TylerBeaton/Ocean-Motion/Tools/Fusion360/PlatformSolverInvestigation/HANDOFF.md

# Fusion platform solver investigation — resume here

## User contract
Investigate script-driven platform poses with Fusion solving all six linkages as it does on mouse drag. Keep ALL existing work untouched. Only create/edit files in this new `Tools/Fusion360/PlatformSolverInvestigation/` directory. Preserve local work and do not commit, push, change branches, or save the user's CAD document without authorization. Offline CAD only; no physical actuator output.

## Workspace
Live repo: `/Users/tylerbeaton/Documents/Unity Projects/Ocean Motion`
Branch: `feature/unity-fusion-telemetry` (upstream fetched and equal at start).
The Hermes `.../orca/workspaces/Ocean Motion/main` tree is a DIFFERENT checkout. Work in the live repo above.
`baseline_hashes.json` records SHA-256 hashes of existing Fusion Python, Markdown, manifests and CSVs; compare before finishing to prove none were modified. Credentials/hidden environment files were not read and must remain untouched.

## Evidence inherited from user tests
- Mouse dragging the top platform articulates the mechanism.
- Direct top.transform2 writes moved the plate but not connected parts. An earlier computeAll() probe moved zero other occurrences.
- Driving root-context revolute joints moves the connected mechanism, but sequential coupled writes plus a fixed heave/two-tilt-only response approximation drift laterally/yaw and visibly pop.
- transformOccurrences([top], [matrix], False) matched a tiny +1 mm world Z / +0.15 deg local X/Y target, yet all six rotationValue changes were zero. User saw a slight plate lift and visible return after OK. This does NOT establish linkage articulation or stationary-base behavior.
- Existing UnityJointVisualPlayback now contains a slowed pose-test and servo body-relative diagnostics. No result from that revised diagnostic has been supplied. Do not modify it.

## Current status / exact next step
LIVE BUILD CHECKPOINT: current tool runtime lists two running children under `deleg_d2a90ce8`: sa-0-0bbceffb builds PlatformReconnectPlayback/ (actual CSV, six positively identified nub attachments only, nonzero proof before preview/full); sa-1-7f0c3046 builds PoseFeedbackPlayback/ (actual CSV, six ordinary revolute drives with numerical full6DOF feedback correcting XY/yaw). Both own separate new folders, must leave CHECKPOINT.md, tests, manifest and explicit disposable-copy consent; no old files or unknown joints changed. These candidates are NOT yet verified. Parent must inspect/run tests and real CSV planning, check frozen40hashes and update MORNING_CHECKLIST before saying ready.

Recovery caveat: the pre-existing paragraph below names `deleg_1e2e4dd1` and two differently named trial folders. It was discovered on a failed-context patch; current delegate list does NOT show that batch and file search found no *Trial* artifacts at this checkpoint. Preserve its notes, but do not assume those children/artifacts exist or succeeded. Reconcile actual files and active tasks on resume rather than overwriting retained work. Current live scopes do not overlap those names.

LATEST USER CORRECTION: diagnostics alone are insufficient. User explicitly requests scripts that actually animate from UNITY RECORDING, accepts multiple experimental attempts on disposable copies in morning. Do not present JointLocator/ManualDragCompare as that deliverable. Two CSV-driven candidates now building in separate folders via delegation `deleg_1e2e4dd1`: sa-0-c088456e UnityCommandPoseTrial (joint-aware transform inside Command.execute; unproved hypothesis), sa-1-688ebfb8 UnityNubReconnectTrial (only six known Nub 1–6 Rigid joints, validated endpoints, suppress/place/ground/reconnect; unrelated unresolved joints strictly untouched). Both explicitly opt-in, bounded <=12 frames / <=2mm / <=0.5deg, first-source-sample-relative; measure actual servo-body articulation/base drift, stop plate-only, log and attempt checked restoration except flag-cleanup failure forbids further writes. Always disposable-copy, no save. Existing old RUN remains blocked.

These new playback candidates are IN FLIGHT, not completed/native-verified. On background delivery parent must inspect source for scope/cleanup/command lifecycle, run tests and real CSV planning, verify 40-file baseline preservation, extend MORNING_CHECKLIST with actual script install/run order and reports. On quota restart check child folder checkpoints and source rather than regenerating. No automatic overnight scheduling promised. Actual Native Fusion solve requires user morning tests; don't claim a fixed animation in advance.

ACTIVE MORNING PACKAGE REQUEST: user finalized model, cannot locate Rigid 4/10, requests a couple of scripts to try in morning and a holdover log for quota restarts. Preserve finalized CAD; no more joint rebuilding. Build isolated JointLocator (read-only report plus opt-in UI selection, no timeline roll) and ManualDragCompare (two-run START/FINISH, user manually drags between runs, script only reads). These are prerequisite diagnostics, NOT a claim of fixed automated playback. Existing RUN stays blocked; no blanket skipping unknown constraints.

MORNING PACKAGE COMPLETE LOCALLY: delegation `deleg_630d933a` finished both scripts. Parent inspected source/manifests, reran JointLocator (7 passing), ManualDragCompare (10 passing), original investigation (12 passing), compilation and diff checks; verified all 40 frozen file hashes unchanged. Parent fixed missing RevoluteJointMotion cast in ManualDragCompare angle adapter with red/green regression. Child ZIP/test-results artifact predates that correction; current source is authoritative. No live Fusion execution of either new script yet. MORNING_CHECKLIST.md now contains exact install paths, batched steps, limits and reports to return. No pending background child work or overnight scheduler.

RESUME HERE: await JointLocator report (optionally its UI-only selection result) and ManualDragCompare START/manual drag/FINISH result from disposable copy. Do not regenerate scripts or ask user to hunt Browser branches. JointLocator enumerates component-owned collections and optional selects a matching contextual entity without rolling timeline. ManualDragCompare keeps same-live-document state in sys.modules with documentClosing invalidation, compares body-relative rotations, never writes CAD or restores poses, and does not gate on unrelated as-built flags. Treat API stand-in tests as software checks only; native document equality/session persistence and selection behavior require actual Fusion trial. Existing RUN stays blocked. Finalized original must remain untouched.

Latest actual audit `probe-34fdf7d1ede54d56a370f401985f9164.jsonl`: Rigid4 and Rigid10 owned by root Hexapod Base (1), timeline indices16/24, native endpointOne throws. Six additional Rigid7 contextual as-built joints (Leg Assembly:1..6) throw on isSuppressed (jointOcc), while endpoint reads name Crankshaft Pin:1 / Crankshaft:1 and native endpoint reads work. Total eight unreadable records again; this is NOT regression of repaired servo mounts. No native motion experiment has run. User could not locate even using timeline; stop sending manual search instructions.

CURRENT: report `probe-7ebba42d91ef410ea02793f48411db39.jsonl` verified all six rebuilt Servo 1–6 Rigid joints connect matching leg Servo:1 components to renamed Base Hexagon:1 with no errors. Six renamed nub-to-top rigid joints also read correctly. Only Rigid 4 and Rigid 10 remain unreadable. User searched all Browser relationships and found neither. Earlier suggestions that native joints must be at root or under Top Platform were unsupported; do not repeat them. User requests concise, batched guidance to conserve usage.

AUDIT now additionally records parentComponent.name and timelineObject {index,name}, capturing getter errors rather than blocking report collection. Installed Autodesk definitions verified these properties; index is zero-based and may be -1 for members of collapsed timeline groups, so -1 is NOT proof of deletion. Next: user reruns AUDIT and provides path; inspect these actual owner/location fields before suggesting any repair or deletion. No timeline roll, selection, or CAD changes added. 12 tests pass, compile/diff checks pass, all 40 old-file hashes unchanged.

NEWEST VERIFIED REPAIR (supersedes historical next steps below): user confirmed Component15:1 is the grounded bottom plate; Hexapod Base:1 contains sketches, not the plate. Old Servo 1 Rigid tooltip named root Hexapod Base (1). User rebuilt ONLY Servo 1 Rigid as an As-Built Rigid joint with explicit servo and base component selections. Report `reports/probe-175273a673d742acbfd318cd8253092b.jsonl` contains exactly one Servo 1 Rigid: one=Leg Assembly:1+Servo:1, two=Component15:1, suppressed=false, errors={}, metadata_errors={}. Unreadable-joint count dropped from 8 to 7; five remaining servo mounts plus Rigid 4/10 retain errors. This demonstrates a working reference repair for one mount, NOT native motion/solver success and NOT that As-Built joints are inappropriate.

Next: on disposable copy rebuild only the remaining five servo-to-base rigid mounts using actual Servo components and Component15:1, preserving revolutes/ball/linkage joints. Joint names are not reliable leg indices (e.g. Servo 3 Rigid mapped to Leg Assembly:4). Then AUDIT again. Leave Rigid 4/10 untouched until their intended counterpart is identified. RUN remains blocked while references/topology are unresolved. No code change needed for this result; checkpoint only.

LATEST (supersedes earlier next-step notes below): second native report `reports/probe-902da664ddd644bbb8ff63cb60ce6175.jsonl` identifies eight failing as-built endpoints: Servo 1–6 Rigid occurrenceTwo, Rigid 4 / Rigid 10 occurrenceOne. Rigid 4/10 both have readable occurrenceTwo = Top Platform:1. Six other readable rigid joints connect nubs to the top. Selected base was Component15:1. Thus the original six-total-attachment assumption is unverified and may be wrong. Do not skip these joints or relax the count. No motion/model changes occurred.

New default AUDIT mode in the same script is READ ONLY and needs no selections. It compares existing joint proxy endpoint reads with nativeObject endpoint reads when available, captures isValid/assemblyContext and all occurrence paths. Native paths are component-relative, diagnostic only; never concatenate/replace root paths without validating instance context. already_native=true distinguishes nativeObject=None from a getter error. If native reads work where proxy reads fail, investigate context mapping; if already native or both fail, inspect definitions in Fusion before guessing repair. Autodesk nativeObject docs confirm its component-relative context. Root cause remains unproved.

Latest audit read: `reports/probe-2e1ff6a160d1447f95684a7db3f00558.jsonl` has start/audit/complete. All eight failing joints report isValid=true, assemblyContext=null, already_native=true, metadata_errors={}. Thus there is no proxy-to-native fallback available for these objects; the failing accessors are already on native joints. This does NOT prove the CAD joints are broken: unresolved/deleted references and an API accessor defect remain possibilities. No code or CAD repair is justified from that alone. Occurrence list includes Hexapod Base:1 plus Component15:1 and Component15:2; the earlier selected base Component15:1 has not been visually identified as the fixed base.

Next action: on the disposable copy, inspect Servo 1 Rigid in Fusion's Edit Joint dialog; capture the two component selections and any warning, then Cancel without edits. Use that to distinguish UI-readable valid references from missing definitions. Do not request another identical audit or blindly suppress/recreate mounts. Test suite last verified at 12 passing; audit is read-only and no native motion has run. Preserve the original six-attachment assumption as UNVERIFIED.

Discovery completed for installed wrapper signatures; see `RESEARCH.md`. First native run stopped in read-only inventory before motion. No replacement animation or per-frame solver success is established. Baseline covers 40 existing files.
Research child completed. Parent verified an exact-match historical failure and an accepted community workaround; URLs and limitations are recorded in RESEARCH.md.
Implementation ready for the hands-on Fusion gate: `PlatformSolverInvestigation.py` and matching manifest, `reconnect.py`, `measurements.py`, README and tests. The entry script selects top/base components, inventories ordinary and as-built joints, and requires explicit RUN authorization on a disposable copy. It requests +1 mm world Z in six steps with 0.5-second pauses using suppress → place → temporarily ground → reconnect → yield → unground. Each step must show all six servo-body relative rotations, correct full top pose, and stationary base before proceeding. There is no generic solveAssembly API or command-context fix established.
Next: user reruns this NEW script on a disposable copy and supplies the new report. First run on Fusion 2705.1.25 failed at AsBuiltJoint.occurrenceTwo with `2 : InternalValidationError : res`; report `reports/probe-8045eb991d524395a4ca823c137babb4.jsonl` has only start/error, no joint identity. No model changes were reached. Updated inspect_joints captures each property error and joint name/family/index, then run writes the full audit BEFORE inventory validation. Unreadable joints still block mutation, including suppressed joints; no endpoint fallback or silent exclusion is used. This improves diagnosis, not native solver behavior. Native motion and automatic closure remain unverified; do not expand to CSV.

## Current implementation / verification checkpoint
- 12 local tests pass: `python3 -m unittest discover -s Tools/Fusion360/PlatformSolverInvestigation/tests -v`. Compilation and `git diff --check` pass. Regression reproduces a throwing occurrenceTwo accessor, verifies inventory is retained in the JSONL report, and asserts experiment is never called. Entry/UI/report wiring uses API stand-ins; native motion is untested.
- SHA-256 comparison found all 40 baseline files unchanged. Keep old player/tests untouched.
- Live branch remains `feature/unity-fusion-telemetry`; latest fetch showed 0 ahead / 0 behind upstream. Existing unrelated working-tree changes remain; no commits, branch switches, or CAD saves performed.
- JointMotion must be cast to RevoluteJointMotion before reading rotationValue/rotationLimits; regression test covers this.
- Finite pose math rejects NaN/Infinity. Relative servo-body rotation cancels shared rigid movement; top-only movement cannot pass. Component snapshots use root.allOccurrences paths, not native nested local transforms.
- Bounds: base 0.05 mm / 0.02 deg, top pose error 0.1 mm / 0.05 deg, servo motion detection >0.001 deg, joint/body excursion <=10 deg. Enabled Fusion angle limits retained. These are visualization diagnostic checks, not hardware safety limits or atomic-solve guarantees.
- Records flush to new `reports/probe-<uuid>.jsonl` within this folder. Log start/version, inventory, baseline, grounded/released snapshots, step summaries, restoration, errors. First genuine report is the read-only failure noted above; no real motion results yet.
- Restoration attempts the initial top pose and checks every captured occurrence at 0.1 mm / 0.05 deg plus six angle readbacks at 0.05 deg. Native solver failure may leave geometry different despite flags returning correctly. Close the disposable copy WITHOUT SAVING even on nominal success.
- `StateRestoreError` stops further CAD mutations after failed flag cleanup. Preserve this distinction from ordinary solver/measurement errors, where bounded starting-pose restoration is attempted.

## Resume discipline
Read this file, README/research if present, and current files before writing. Retry after a quota interruption can leave partially completed edits. Re-run focused tests and inspect what exists rather than regenerating it. Update this handoff after each material discovery or completed stage. Actual Fusion behavior needs a hands-on gate; synthetic Python tests cannot verify Autodesk's assembly solver.
