TylerBeaton/Ocean-Motion/Tools/Fusion360/PlatformSolverInvestigation/JointLocator/CHECKPOINT.md

# JointLocator checkpoint

- Completed standalone script, manifest, README and unittest suite in this folder only.
- TDD evidence: initial `locate` test failed (missing API), then passed; contextual/error tests exposed uncaught getter/collection failures, then passed; export/selection test failed (missing `execute`), then passed.
- Final command: `python3 -B -m unittest discover -s '/Users/tylerbeaton/Documents/Unity Projects/Ocean Motion/Tools/Fusion360/PlatformSolverInvestigation/JointLocator/tests' -v`
- Final result: **Ran 7 tests in 0.046s — OK**. Covers fresh enumeration, repeated contexts, endpoint/collection errors, report-before-selection, blank/cancel/invalid/false/throw/success paths, missing proxy, entrypoint and static mutation guard.
- Installed Autodesk API definitions checked. No live Fusion/CAD action performed; no real-model report generated. Native Fusion enumeration/selection remains a human test.
- Reports will appear under `reports/joint-locator-<unique-id>.json`; selection outcome is a separate final dialog, never an edit to the report.
- No suppression (even getter), timeline movement, grounding, transforms, deletion, save, commit, push, branch switch, or other-file modifications requested/performed.
- Workspace checkout is clean `main`; explicit destination checkout is `feature/unity-fusion-telemetry` with pre-existing local changes. Neither was synchronized or switched because this isolated task forbids unrelated changes.
