TylerBeaton/Ocean-Motion/(list of files, cad)

Other CAD files:
Assets/Models/Axis.obj
Assets/Models/Exported/Crankshaft.obj
Assets/Models/Exported/Top Platform.obj
Assets/Models/Exported/Base Hexagon Bottom.obj
Assets/Models/Exported/Linkage Rod.obj
Assets/Models/Exported/Base Hexagon Bottom.f3d
Assets/Models/Exported/Top Platform.f3d
