TylerBeaton/Ocean-Motion/Arduino/08_GROUP_TEST/recorded-group-endpoints-2026-10-31.csv

direction | progress_percent | servo0_us | servo1_us | servo2_us | servo3_us | servo4_us | servo5_us | stop_reason
raised | 100 | 2000 | 1000 | 2000 | 1000 | 2000 | 1000 | software_guardrail
lowered | -100 | 1000 | 2000 | 1000 | 2000 | 1000 | 2000 | software_guardrail
