TylerBeaton/Ocean-Motion/Tools/Fusion360/UnityBoatTelemetryPlayback/recordings/boat-telemetry-test-000-20261005-140749.csv

schema_version | sequence | time_seconds | pos_x_m | pos_y_m | pos_z_m | rot_x | rot_y | rot_z | rot_w
1 | 0 | 0.019999992913832365 | 0.06230627 | 0.659347355 | 0.0138864517 | -0.0186703689 | 0.0005126456 | -0.07734412 | 0.9968295
1 | 1 | 0.059999978741497095 | 0.06313121 | 0.666499853 | 0.0125352144 | -0.0204449333 | 0.0004550164 | -0.0776068941 | 0.9967743
1 | 2 | 0.1199999574829933 | 0.06433469 | 0.6768075 | 0.0104786456 | -0.0230823271 | 0.0003677489 | -0.07794944 | 0.99669
1 | 3 | 0.15999994331065803 | 0.06511382 | 0.6833954 | 0.009088695 | -0.02482267 | 0.000309171039 | -0.07814335 | 0.996633053
1 | 4 | 0.21999992205215424 | 0.066246815 | 0.6928464 | 0.006978363 | -0.0274035558 | 0.000220963469 | -0.07838246 | 0.9965467
1 | 5 | 0.25999990787981808 | 0.06697782 | 0.698857248 | 0.005555868 | -0.0291028116 | 0.000162083074 | -0.0785073638 | 0.9964887
1 | 6 | 0.31999988662131607 | 0.06803697 | 0.7074347 | 0.00340101123 | -0.031616997 | 7.39105E-05 | -0.07864295 | 0.99640137
1 | 7 | 0.359999872448979 | 0.0687177 | 0.712858438 | 0.00195211172 | -0.03326845 | 1.537958E-05 | -0.07869886 | 0.996343255
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
