TylerBeaton/Ocean-Motion/Tools/Fusion360/UnityBoatTelemetryPlayback/recordings/boat-telemetry-test-000-20261005-142453.csv

schema_version | sequence | time_seconds | pos_x_m | pos_y_m | pos_z_m | rot_x | rot_y | rot_z | rot_w
1 | 0 | 0.019999992913881215 | 0.0162699 | 0.09326673 | -0.0700073838 | -0.04986762 | 0.00150618353 | -5.85632624E-05 | 0.99875474
1 | 1 | 0.059999978741643645 | 0.0162702054 | 0.0854958147 | -0.0696424246 | -0.04847068 | 0.00150644616 | -5.717352E-05 | 0.998823464
1 | 2 | 0.11999995748305992 | 0.01627067 | 0.07416538 | -0.06903097 | -0.0463161 | 0.00150684593 | -5.45567818E-05 | 0.998925745
1 | 3 | 0.15999994331082235 | 0.01627099 | 0.06683314 | -0.06858143 | -0.044840496 | 0.00150711334 | -5.27665361E-05 | 0.998993039
1 | 4 | 0.21999992205223862 | 0.0162715018 | 0.0561815836 | -0.0678453147 | -0.04257269 | 0.00150751253 | -5.024242E-05 | 0.9990922
1 | 5 | 0.25999990788000105 | 0.016271852 | 0.049316112 | -0.06731403 | -0.0410250351 | 0.00150777865 | -4.83446456E-05 | 0.999157
1 | 6 | 0.31999988662141732 | 0.0162723921 | 0.039382048 | -0.06645775 | -0.0386529565 | 0.00150817435 | -4.548661E-05 | 0.9992516
1 | 7 | 0.35999987244895237 | 0.0162727647 | 0.03300846 | -0.06584811 | -0.0370396152 | 0.00150843489 | -4.35550828E-05 | 0.9993127
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
