TylerBeaton/Ocean-Motion/Tools/Fusion360/UnityBoatTelemetryPlayback/recordings/boat-telemetry-test-bow-20261005-142503.csv

schema_version | sequence | time_seconds | pos_x_m | pos_y_m | pos_z_m | rot_x | rot_y | rot_z | rot_w
1 | 0 | 0.019999992913881215 | 0.0162755866 | 0.0632353 | -0.06835076 | -0.04409148 | 0.001513045 | -5.20304566E-05 | 0.9990264
1 | 1 | 0.059999978741416271 | 0.0162759311 | 0.0561809354 | -0.06785184 | -0.0425726138 | 0.00151331222 | -5.027928E-05 | 0.9990923
1 | 2 | 0.11999995748305992 | 0.0162764732 | 0.045954518 | -0.06704295 | -0.04024072 | 0.00151371048 | -4.762843E-05 | 0.99918884
1 | 3 | 0.15999994331059497 | 0.016276842 | 0.03938119 | -0.0664644539 | -0.0386529751 | 0.00151397462 | -4.56788E-05 | 0.9992516
1 | 4 | 0.21999992205201124 | 0.0162774026 | 0.0298963543 | -0.0655385256 | -0.03622349 | 0.001514366 | -4.26434162E-05 | 0.999342561
1 | 5 | 0.25999990787977367 | 0.01627779 | 0.0238282252 | -0.06488335 | -0.03457335 | 0.00151462248 | -4.06943582E-05 | 0.9994011
1 | 6 | 0.31999988662118994 | 0.01627839 | 0.0151184853 | -0.0638456345 | -0.0320556946 | 0.00151499826 | -3.78209443E-05 | 0.999485
1 | 7 | 0.35999987244895237 | 0.0162788052 | 0.009576529 | -0.06311789 | -0.0303497054 | 0.0015152425 | -3.590266E-05 | 0.999538243
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
