TylerBeaton/Ocean-Motion/Tools/Fusion360/UnityBoatTelemetryPlayback/recordings/boat-telemetry-test-bow-side-000-20261006-132427.csv

schema_version | sequence | time_seconds | pos_x_m | pos_y_m | pos_z_m | rot_x | rot_y | rot_z | rot_w
1 | 0 | 0.019999992913824371 | -0.0406803153 | 0.33695507 | -0.004455358 | -4.39735777E-05 | 0.0038237276 | 0.07894627 | 0.9968716
1 | 1 | 0.039999985827648743 | -0.0411139242 | 0.33105734 | -0.00445505977 | -4.38069255E-05 | 0.00382335577 | 0.07892145 | 0.996873558
1 | 2 | 0.059999978741501536 | -0.0415399373 | 0.325163245 | -0.00445479155 | -4.35879556E-05 | 0.00382297626 | 0.078884095 | 0.9968764
1 | 3 | 0.079999971655325908 | -0.0419582836 | 0.3192738 | -0.004454583 | -4.332471E-05 | 0.00382259046 | 0.07883421 | 0.9968805
1 | 4 | 0.099999964569150279 | -0.0423689075 | 0.313390046 | -0.004454285 | -4.304222E-05 | 0.003822197 | 0.0787717849 | 0.9968853
1 | 5 | 0.11999995748300307 | -0.04277173 | 0.307512939 | -0.004454106 | -4.27168961E-05 | 0.0038217972 | 0.07869686 | 0.9968913
1 | 6 | 0.13999995039682744 | -0.0431667 | 0.301643342 | -0.00445386767 | -4.23517231E-05 | 0.00382139 | 0.0786094144 | 0.996898234
1 | 7 | 0.15999994331065182 | -0.04355375 | 0.295782357 | -0.00445359945 | -4.19305179E-05 | 0.00382097531 | 0.07850948 | 0.9969061
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
