TylerBeaton/Ocean-Motion/Tools/Fusion360/UnityBoatTelemetryPlayback/recordings/boat-telemetry-test-crossed-000-20261006-132917.csv

schema_version | sequence | time_seconds | pos_x_m | pos_y_m | pos_z_m | rot_x | rot_y | rot_z | rot_w
1 | 0 | 0.019999992913824371 | 0.00682682 | -0.0260660276 | -0.09003928 | -0.07275786 | 0.0124503076 | 0.04905161 | 0.9960649
1 | 1 | 0.039999985827648743 | 0.007067075 | -0.03393074 | -0.09034181 | -0.0725910142 | 0.0124335941 | 0.0484752655 | 0.9961055
1 | 2 | 0.059999978741473114 | 0.007312873 | -0.0417582244 | -0.09063524 | -0.07241251 | 0.01241646 | 0.0478945374 | 0.9961468
1 | 3 | 0.079999971655297486 | 0.0075641796 | -0.049547635 | -0.09091973 | -0.07222234 | 0.0123989126 | 0.04730952 | 0.99618876
1 | 4 | 0.099999964569121857 | 0.007820961 | -0.05729784 | -0.09119508 | -0.0720205456 | 0.0123809623 | 0.046720285 | 0.996231437
1 | 5 | 0.11999995748300307 | 0.008083189 | -0.0650081262 | -0.09146145 | -0.07180709 | 0.0123626143 | 0.0461268052 | 0.99627465
1 | 6 | 0.13999995039682744 | 0.008350832 | -0.07267708 | -0.0917184353 | -0.07158204 | 0.0123438826 | 0.045529183 | 0.9963186
1 | 7 | 0.15999994331065182 | 0.008623842 | -0.08030345 | -0.09196645 | -0.0713455155 | 0.0123247756 | 0.0449275337 | 0.996363163
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
