TylerBeaton/Ocean-Motion/(commit log)

2026-08-12 Add Unity to Arduino RGB demo
2026-08-18 feat: stream live rotation telemetry
    Add a Unity-to-Arduino rotation demo and latest-state serial delivery to prevent stale telemetry backlogs.
2026-08-18 feat: add Unity Arduino sketches
    Track the RGB and inverted Y-axis servo firmware alongside the existing rotation telemetry sketch.
2026-08-19 chore: archive numbered subprojects
    Pair each Unity scene and script with its numbered Arduino milestone, and document protocol, dependencies, and reuse.
2026-08-19 chore: start combined pitch-roll archive
    Create paired Unity and Arduino assets for subprojects 03 and 04 without overwriting the verified single-servo milestone.
2026-08-19 fix: rename pitch-roll archive to pitch-yaw
    Correct the combined 03_04 Arduino, Unity scene, script, class, and documentation names while preserving Unity GUIDs.
    [03_04_UNITY_PITCH_YAW.ino]
2026-08-19 feat: control pitch and yaw servos
    Keep the ROT packet while mapping Unity X and Y rotation to independent pitch and yaw servo outputs with neutral timeout handling.
2026-08-19 feat: model calibrated pitch-yaw joint chain
2026-08-19 fix: correct serial joint axes
2026-08-24 [verified] chore: archive Subprojects 03-04 and 05 setup
    Preserve the latest pitch/yaw scene, SG90 model, material adjustments, and the initial Update 05 scene placeholder from the last two subprojects.
    Ignore locally installed Amplify Shader Editor and RootMotion/FinalIK vendor payloads so fresh checkouts do not inherit large Asset Store plugin trees. The archived 03/04 scene retains optional FinalIK component references, which can be restored by reinstalling FinalIK.
2026-08-24 chore(unity): track agent instructions metadata
2026-08-24 feat: add shared wave simulation stage
2026-08-26 docs(05): record boat buoyancy baseline
    Document the shared wave-to-buoyancy architecture, four-point Zodiac layout, height bias, initial tuning observations, Input System assembly reference, and remaining validation sequence.
2026-09-02 Created telemetry scripts
    After verifying calibration I created telemetry scripts to display telemetry data for recording/posting update.
2026-09-07 feat(05): add water wireframe shader
2026-09-08 Update README.md
    I felt the previous policy was not reflective of how I currently use AI in this project and wanted to make it more accurate to how I use it from start to finish within a pipeline.
2026-09-21 Added axis model
    To better represent the processed/unprocessed motion of the boat.
    [Axis.obj]
2026-09-22 feat(sp06.2): add LCD servo telemetry demo
2026-09-22 feat(sp06.2): add roll servo output
2026-09-23 feat(sp06.2): drive servos through PCA9685
2026-09-23 test(sp06.2): widen pitch and roll to 70 degrees
2026-09-24 refactor(sp06.2): isolate two-servo hardware
2026-09-24 fix(sp06.2): record calibrated servo neutral trims
    [MotionHardware.h, motion_hardware_tests.cpp]
2026-10-05 feat(telemetry): add Unity to Fusion playback bridge
    [sample-telemetry.csv]
2026-10-13 feat(sp07): add Stewart platform Fusion playback demo and servo labels
2026-10-13 feat(sp07): archive Fusion playback investigations and recordings
    Preserve the Unity-to-Fusion experiment state: recorder Inspector controls and configurable CSV output, playback waterline offset and scale, a rebuilding scene, additional CAD exports, and captured telemetry recordings.
    Add Fusion joint/solver probes, reconnect and pose-feedback playback experiments, visual playback tooling, tests, verification reports, and investigation notes. Include the current Unity package/material/settings changes from the working tree.
    Ignore local .env files containing machine-specific PYTHONPATH settings. The playback and solver work remains experimental; these scripts do not provide hardware-safe a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
2026-10-31 feat(sp08): add manual servo pair calibration and bench results
2026-11-02 feat(sp08): archive six-servo neutral and travel trials
2026-11-02 docs(sp09): save physical calibration handoff
2026-11-05 feat(sp09): publish guarded OI3 IK with lean test scenes
    - Drive boat motion and manual poses from the same six-servo IK solution as the preview, with neutral-only configuration, bounded arming and watchdog HOLD.
    - Keep the current boat and pose-sweep scenes, self-contained OI3 firmware tests and reproducible builders; preserve committed milestone archives.
    - Remove inactive telemetry/comparison UI and save compact numerical summaries, with full diagnostics available through --full-report.
    - Document provisional geometry/pulse calibration, accepted single-axis trials and the unresolved Crossed-wave limit.
    - Validate numerical fixtures, firmware compilation/protocol tests, scene rebuilds and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
2026-11-09 feat(sp09): add repeatable timed IK trials and smooth wave transitions
    - Replace repetitive setup clicks with configurable Prepare/Arm/Stop controls,
    duration/countdown handling, and gradual neutral return after each test.
    - Upgrade the receiver to OI5 with 25-500us offset allowances and 50-500us/s
    motion speeds, exact ARM echoes, absolute 1000-2000us bounds, fixed slow
    HOME, retained-offset recovery, and a fractional reversal rounding fix.
    - Record separate timestamped telemetry files per armed run with settings,
    target/board commands, motion clocks, transitions, and stop reasons;
    keep recordings and plots local through the TestLogs ignore rule.
    - Add opt-in 1-3s phase-preserving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
2026-11-09 docs: update milestone checklist through live platform integration
    Mark prototype milestones 07-11 complete, retain completed motion-pipeline/CAD work, and describe progress on tuning, calibration, the public demo, and the retrospective. Keep final architecture, loaded testing, and measured workspace validation explicit.
2026-11-11 feat(sp09): add wave speed control for ACK and servo speed testing
    - Add a 0–4x water-speed multiplier in 0.25 increments to vary motion demand for ACK response and overall servo-speed testing.
    - Preserve wave phase when changing speed and share the travel clock between rendering and buoyancy; keep physics and preset-transition timing independent.
    - Apply next-run speed through Prepare, guard against unapplied settings on Arm, and log active water speed and wave time alongside servo commands.
    - Add deterministic speed tests, USB-disabled integration checks, and operating/handoff documentation.
    Validation: 18/18 SP05 EditMode tests passed; USB-disabled preparation, telemetry, and 4x Bow/Si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
